lhr-solar/PS-BPSLeader/hardware/PS-BPSLeader.kicad_pcb

## KiCad design hardware/PS-BPSLeader.kicad_pcb (2026-09-20)

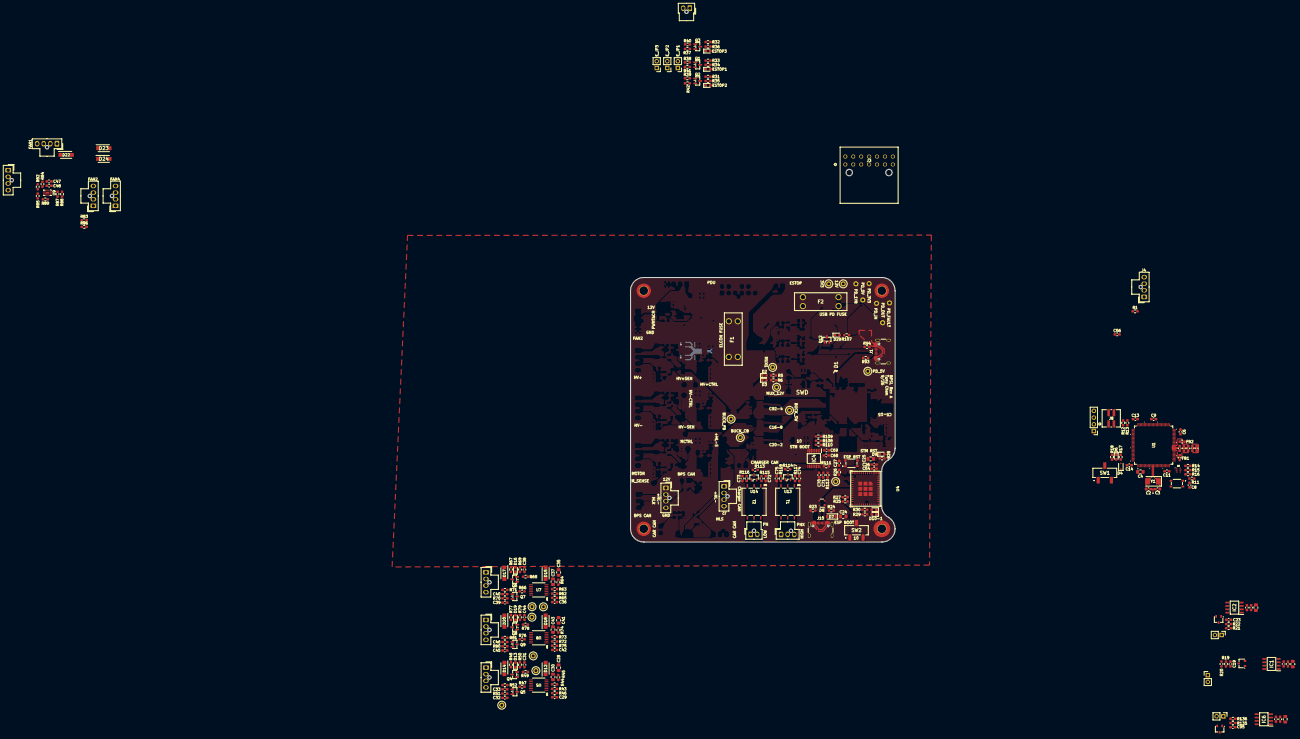
[picture p1: board PS-BPSLeader.kicad_pcb from above]

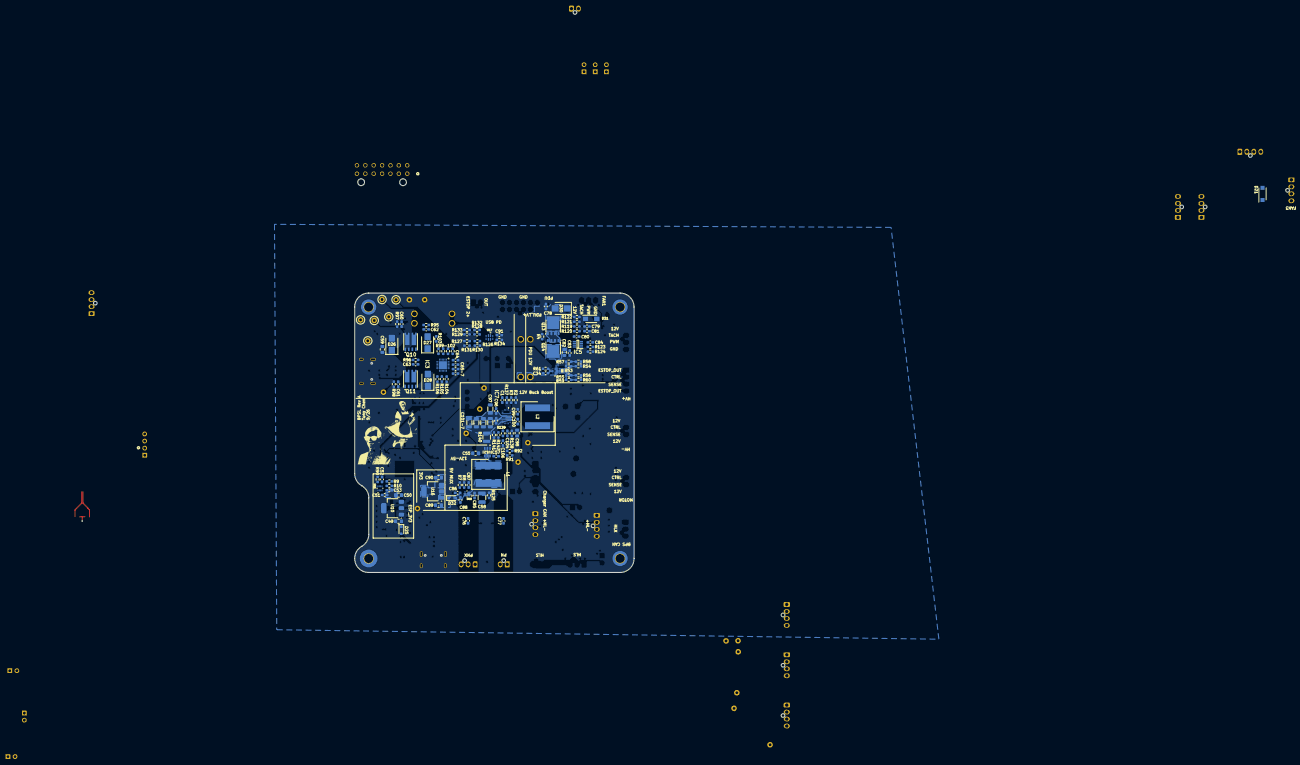
[picture p2: board PS-BPSLeader.kicad_pcb from below]

Board: 4 copper layers, 100.0 x 100.0 mm, 387 parts (131 on the bottom side), 233 nets.

Parts:
C1: 7.5n; C_0603_1608Metric_Pad1.08x0.95mm_HandSolder
C2, C3: 26p; C_0603_1608Metric_Pad1.08x0.95mm_HandSolder
C4, C16, C20, C49, C50, C82, C89, C90, C92: 10u; C_0805_2012Metric_Pad1.18x1.45mm_HandSolder
C5, C6, C7, C8, C9, C11, C13, C14, C15, C17, C18, C19, C21, C22, C23, C33, C40, C46, C68, C71, C78, C83, C84, C93, C94, C95, C96, C99, C100, C107: 0.1u; C_0603_1608Metric_Pad1.08x0.95mm_HandSolder
C10, C12, C29, C32, C34, C36, C39, C42, C45, C47, C48, C79, C91: 1u; C_0603_1608Metric_Pad1.08x0.95mm_HandSolder
C24, C25, C59: 10uF; C_0805_2012Metric_Pad1.18x1.45mm_HandSolder
C26, C27, C51, C52, C53, C54, C66, C67, C85, C86, C87, C88: 0.1uF; C_0603_1608Metric_Pad1.08x0.95mm_HandSolder
C28, C30, C35, C37, C41, C43, C55, C98: 4.7u; C_0805_2012Metric_Pad1.18x1.45mm_HandSolder
C31, C38, C44: 0.1n; C_0603_1608Metric_Pad1.08x0.95mm_HandSolder
C56, C57: 100n; C_0603_1608Metric_Pad1.08x0.95mm_HandSolder
C58: 47u; C_1210_3225Metric_Pad1.33x2.70mm_HandSolder
C60, C61, C62, C63, C64, C65: 1uF; C_0603_1608Metric_Pad1.08x0.95mm_HandSolder
C69, C70: 0.22u; C_0603_1608Metric_Pad1.08x0.95mm_HandSolder
C72, C73, C74, C75, C76, C77: 100pF; C_0603_1608Metric_Pad1.08x0.95mm_HandSolder
C80: 220n; C_0603_1608Metric_Pad1.08x0.95mm_HandSolder
C81: 10n; C_0603_1608Metric_Pad1.08x0.95mm_HandSolder
C97, C101, C102, C103, C105: 22u; C_1206_3216Metric
C104: 45p; C_0603_1608Metric_Pad1.08x0.95mm_HandSolder
C106: 90n; C_0603_1608Metric_Pad1.08x0.95mm_HandSolder
D1: TPD2EUSB30DRTR
D2, D3: LED; LED_0603_1608Metric
D4: TVS; D_SOD-323
D5: RGB_LED
D6: LED; LED_0603_1608Metric_Pad1.05x0.95mm_HandSolder
D7: 1N5819HW-7-F; D_SOD-123
D8: SP0503BAHT; SOT-143
D9: ESP_PWR; LED_0603_1608Metric_Pad1.05x0.95mm_HandSolder
D10: ESP_LED1; LED_0603_1608Metric_Pad1.05x0.95mm_HandSolder
D11: ESP_LED2; LED_0603_1608Metric_Pad1.05x0.95mm_HandSolder
D12, D14, D15, D17, D18, D20, D21, D22, D23, D24: VSSAF522-M3/H; SODFL5226X100N
D13, D16, D19: Contact; LED_0603_1608Metric_Pad1.05x0.95mm_HandSolder
D25, D32: SBA130CH-AU_R1_000A1; D_SOD-323_HandSoldering
D26: SMBJ24A-E3_52; D_SMB
D27, D28: SMBJ10A-E3_52; D_SMB
D29: FAULT; LED_0603_1608Metric_Pad1.05x0.95mm_HandSolder
D30: SMBJ15CA; D_SMB
D31: SMAF4758A; SODFL5026X125N
ESTOP1, ESTOP2, ESTOP3: LED; LED_0603_1608Metric_Pad1.05x0.95mm_HandSolder
E_JP1, E_JP2, E_JP3: Jumper_2_Open; PinHeader_1x02_P2.54mm_Vertical
F1, F2: 5A; Fuse-3557-2
FAN1, FAN2, FAN3, FAN4: Conn_01x04; Molex_Nano-Fit_105309-xx04_1x04_P2.50mm_Vertical
FB1, FB2: FerriteBead; L_0603_1608Metric_Pad1.05x0.95mm_HandSolder
H1: MountingHole_Pad; MountingHole_3.2mm_M3_Pad_TopBottom
H2, H3, H4: MountingHole_Pad; MountingHole_3.2mm_M3_ISO14580_Pad_TopBottom
IC1, IC2, IC6: TCAN3413DR
IC3: CYPD3177-24LQXQ
IC4: BQ79600PWRQ1; SOP65P640X120-16N
IC5: LM74502DDFR
IC7: TPS552872RYQR; TPS552892QWRYQRQ1
J1, J10: USB_C_Receptacle_USB2.0_16P; USB_C_Receptacle_GCT_USB4105-xx-A_16P_TopMnt_Horizontal
J2: ELCON CAN DEBUG; Molex_Nano-Fit_105309-xx04_1x04_P2.50mm_Vertical
J3: Conn_02x07_Counter_Clockwise; Molex_Microfit3.0_02x07_14-Pin-Horizontal-PCB-Receptacle_44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
J4: CAR CAN DEBUG; Molex_Nano-Fit_105309-xx04_1x04_P2.50mm_Vertical
J5: BPS CAN DEBUG; Molex_Nano-Fit_105309-xx04_1x04_P2.50mm_Vertical
J6: High Side Conn; Molex_Nano-Fit_105309-xx03_1x03_P2.50mm_Vertical
J7: Low SIde Conn; Molex_Nano-Fit_105309-xx02_1x02_P2.50mm_Vertical
J8: SWD_Header; SWD_Conn
J9: SWD; PinHeader_1x04_P2.54mm_Vertical
J11: Conn_01x02; Molex_Nano-Fit_105309-xx02_1x02_P2.50mm_Vertical
J12, J13, J14: Contactor Connector; Molex_Nano-Fit_105309-xx04_1x04_P2.50mm_Vertical
JP1, JP2, JP3: TRM; PinHeader_1x02_P2.54mm_Vertical
L1: 8.2u; 74439369082
L2: 4.7u; 74439369082
LOGO1: Dr. Hallock; LHRs_LOGO
LOGO2: Dr. Hallock; Hallock_Image_Tiny
Q1, Q2, Q3: SQ2315CES-T1_GE3; SOT-23
Q4, Q5, Q6, Q7, Q8, Q9, Q12: IRLML0030; SOT-23
Q10, Q11: SI7997DP-T1-GE3
Q13, Q14: PSMN012-100YS; LFPAK56
R1, R4, R44, R63, R73: 0; R_0603_1608Metric_Pad0.98x0.95mm_HandSolder
R2: 30.1k; R_0603_1608Metric_Pad0.98x0.95mm_HandSolder
R3, R54, R56, R58, R60, R127, R129, R131, R133: 5k; R_0603_1608Metric_Pad0.98x0.95mm_HandSolder
R5, R6, R14, R15, R16, R18, R28, R29, R30, R34, R35, R36, R45, R50, R64, R69, R74, R79, R95, R96, R101, R113, R114: 1k; R_0603_1608Metric_Pad0.98x0.95mm_HandSolder
R7: 16k; R_0603_1608Metric_Pad0.98x0.95mm_HandSolder
R8, R104: 4.7k; R_0603_1608Metric_Pad0.98x0.95mm_HandSolder
R9: 18k; R_0603_1608Metric_Pad0.98x0.95mm_HandSolder
R10, R11, R17, R25, R26, R27, R31, R32, R33, R37, R38, R39, R47, R51, R52, R66, R70, R71, R76, R80, R81, R82, R83, R85, R86, R87, R88, R90, R97, R107, R108, R109, R119, R125: 10k; R_0603_1608Metric_Pad0.98x0.95mm_HandSolder
R12, R13: 22; R_0603_1608Metric_Pad0.98x0.95mm_HandSolder
R19, R20, R21, R22, R135, R136: 60; R_0603_1608Metric_Pad0.98x0.95mm_HandSolder
R23, R24, R93, R94, R99, R100, R102: 5.1k; R_0603_1608Metric_Pad0.98x0.95mm_HandSolder
R40, R41, R42, R84, R89: 33k; R_0603_1608Metric_Pad0.98x0.95mm_HandSolder
R43, R62, R72: 66.67k; R_0603_1608Metric_Pad0.98x0.95mm_HandSolder
R46, R65, R75: 120k; R_0603_1608Metric_Pad0.98x0.95mm_HandSolder
R48, R67, R77: 4.3k; R_0603_1608Metric_Pad0.98x0.95mm_HandSolder
R49, R68, R78: 1; R_0603_1608Metric_Pad0.98x0.95mm_HandSolder
R53, R126, R132: 57.6k; R_0603_1608Metric_Pad0.98x0.95mm_HandSolder
R55: 67.3k; R_0603_1608Metric_Pad0.98x0.95mm_HandSolder
R57, R130: 26.1k; R_0603_1608Metric_Pad0.98x0.95mm_HandSolder
R59: 37.4k; R_0603_1608Metric_Pad0.98x0.95mm_HandSolder
R61, R134: 22.1k; R_0603_1608Metric_Pad0.98x0.95mm_HandSolder
R91, R110, R111, R121, R123, R128, R141: 100k; R_0603_1608Metric_Pad0.98x0.95mm_HandSolder
R92: 19.1k; R_0603_1608Metric_Pad0.98x0.95mm_HandSolder
R98, R103: 49.9k; R_0603_1608Metric_Pad0.98x0.95mm_HandSolder
R105, R106: 2.2k; R_0603_1608Metric_Pad0.98x0.95mm_HandSolder
R112: 10; R_0603_1608Metric_Pad0.98x0.95mm_HandSolder
R115, R116, R117, R118: 51; R_0603_1608Metric_Pad0.98x0.95mm_HandSolder
R120: 33; R_0603_1608Metric_Pad0.98x0.95mm_HandSolder
R122: 7.32k; R_0603_1608Metric_Pad0.98x0.95mm_HandSolder
R124: 15.8k; R_0603_1608Metric_Pad0.98x0.95mm_HandSolder
R137: 50k; R_0603_1608Metric_Pad0.98x0.95mm_HandSolder
R138: R_US; R_0603_1608Metric_Pad0.98x0.95mm_HandSolder
R139: 1.455k; R_0603_1608Metric_Pad0.98x0.95mm_HandSolder
R140: 12.5m; R_1210_3225Metric
R142: 11.1k; R_0603_1608Metric_Pad0.98x0.95mm_HandSolder
Reset1: Reset; TL3365AF180QG
SW1: SW_SPDT; BootSW
SW2: BOOT Switch; BootSW
SW3: RESET Button; TL3365AF180QG
T1, T2: HMU1228NL; HMU1228NL_PUL
TP1: PD_5V; TestPoint_Loop_D1.80mm_Drill1.0mm_Beaded
TP2: PDU_ELCON; TestPoint_Loop_D1.80mm_Drill1.0mm_Beaded
TP3: MUX_12V; TestPoint_Loop_D1.80mm_Drill1.0mm_Beaded
TP4, TP6, TP8: ctrl; TestPoint_Loop_D1.80mm_Drill1.0mm_Beaded
TP5, TP7, TP9: Sense; TestPoint_Loop_D1.80mm_Drill1.0mm_Beaded
TP10: V_in_12V; TestPoint_Loop_D1.80mm_Drill1.0mm_Beaded
TP11: CB; TestPoint_Loop_D1.80mm_Drill1.0mm_Beaded
TP12: FB; TestPoint_Loop_D1.80mm_Drill1.0mm_Beaded
TP13: SW; TestPoint_Loop_D1.80mm_Drill1.0mm_Beaded
TP14: VBUS_IN; TestPoint_Loop_D1.80mm_Drill1.0mm_Beaded
TP15: PD_VBUS_OUT; TestPoint_Loop_D1.80mm_Drill1.0mm_Beaded
TP16: PD_5V_OUT; TestPoint_Loop_D1.80mm_Drill1.0mm_Beaded
TP17: PD_1V8; TestPoint_Loop_D1.80mm_Drill1.0mm_Beaded
TP18: PD_3V3; TestPoint_Loop_D1.80mm_Drill1.0mm_Beaded
TP19: PD_FAULT; TestPoint_Loop_D1.80mm_Drill1.0mm_Beaded
TP_3.3V1, TP_3.3V2: 3.3V; TestPoint_Loop_D1.80mm_Drill1.0mm_Beaded
U1: STM32G473VETx; 100PinMCU
U2, U3, U18: CDSOT23-T24CAN
U4: ESP32-C6-MINI-1
U5, U7, U8: DRV110APWR; PW14_TEX
U6, U17: TPS2121RUXR
U9: EMC2305-1-AP-TR; QFN-16-1EP_1.8x2.6mm_P0.4mm_EP0.7x1.5mm
U10, U16: MCP1826S; SOT-223-3_TabPin2
U11, U15: TPS2117DRLR
U12: LMR51635XDDCR; DDC0006A-MFG
U13, U14: PESD5V0L2BT; SOT23_NXP
Y1: Crystal; Crystal_SMD_Abracon_ABM3-2Pin_5.0x3.2mm

Connections:
+3.3V: C4.1, C6.1, C9.1, C11.1, C13.1, C14.1, C16.1, C17.1, C18.1, C20.1, C21.1, C22.1, C47.1, C48.1, C52.1, C68.1, C90.2, C92.1, C93.1, C94.1, FB2.1, IC1.3 (VCC), IC1.5 (SHDNV_IO), IC2.3 (VCC), IC2.5 (SHDNV_IO), IC4.3 (VIO), IC6.3 (VCC), IC6.5 (SHDNV_IO), J8.1, J9.1, Q1.2 (S), Q2.2 (S), Q3.2 (S), Q5.3 (D), Q7.3 (D), Q9.3 (D), R5.1, R6.1, R11.2, R47.2, R66.2, R76.2, R82.1, R83.1, R84.1, R85.1, R86.1, R87.1, R88.1, R89.1, R108.1, R109.1, R110.1, SW1.1 (A), TP_3.3V2.1 (1_1), U1.6 (VBAT), U1.24 (VDD), U1.49 (VDD), U1.64 (VDD), U1.75 (VDD), U1.100 (VDD), U9.3 (VDD), U11.6 (VIN2), U16.3 (VO)
+3.3V_ESP: C25.1, C25.2, C26.1, C26.2, C54.1, R26.1, R27.2, R28.1, SW2.1 (A), U4.3 (3V3), U11.2 (VOUT), U11.7 (VOUT__1)
+5V: C88.1, D32.2 (A), U15.2 (VOUT), U15.7 (VOUT__1)
+12V: C28.1, C41.1, C55.1, C56.1, D14.1 (K), D20.1 (K), D21.1 (K), D22.1 (K), D23.1 (K), D24.1 (K), E_JP1.1 (A), FAN1.1, FAN2.1, FAN3.1, FAN4.1, IC7.13 (ISN), J3.6, J4.1 (12V), J5.1 (12V), J12.1 (Con+(12V)), J12.4 (Sense+(12V)), J14.1 (Con+(12V)), J14.4 (Sense+(12V)), R45.2, R48.2, R74.2, R77.2, R112.2, R140.2, R141.2, TP10.1 (1_1), U12.2 (EN), U12.3 (VIN)
/BMS/COMHN: C75.1, IC4.12 (COMHN), R114.2, R118.1
/BMS/COMHP: C74.1, IC4.13 (COMHP), R114.1, R117.1
/BMS/COMLN: C72.1, IC4.11 (COMLN), R113.1, R115.1
/BMS/COMLP: C73.1, IC4.10 (COMLP), R113.2, R116.1
/BMS/INH: IC4.16 (INH), R111.1
/BMS_NFAULT: IC4.2 (NFAULT), R110.2, U1.25 (PA3)
/BMS_UART_RX: IC4.4 (MOSI/RX), R108.2, U1.80 (PC11)
/BMS_UART_TX: IC4.5 (MISO/TX), R109.2, U1.79 (PC10)
/BPS_CAN_H: IC6.7 (CANH), J5.2 (CAN_H), R135.1, U18.1 (CAN_H)
/BPS_CAN_L: IC6.6 (CANL), J5.3 (CAN_L), JP3.2 (B), U18.2 (CAN_L)
/CAR_CAN_H: IC1.7 (CANH), J3.2, J4.2 (CAN_H), R19.1, U2.1 (CAN_H)
/CAR_CAN_L: IC1.6 (CANL), J3.3, J4.3 (CAN_L), JP1.2 (B), U2.2 (CAN_L)
/CAR_SHIELD: J3.4, R1.2
/CHARGER_CAN_H: IC2.7 (CANH), J2.2 (CAN_H), J3.13, R21.1, U3.1 (CAN_H)
/CHARGER_CAN_L: IC2.6 (CANL), J2.3 (CAN_L), J3.12, JP2.2 (B), U3.2 (CAN_L)
/ELCON_LV+: F1.1, J2.1 (12V), J3.5
/ESTOP_1-/2+: E_JP1.2 (B), E_JP2.1 (A), J3.7, J3.9, R40.2
/ESTOP_1_SENSE: R32.2, U1.84 (PD2)
/ESTOP_2-: E_JP2.2 (B), E_JP3.1 (A), J3.8, J11.1, R41.2
/ESTOP_2_SENSE: R33.2, U1.85 (PD3)
/ESTOP_3_SENSE: R31.2, U1.86 (PD4)
/ESTOP_OUT: C35.1, D17.1 (K), E_JP3.2 (B), J11.2, J13.1 (Con+(12V)), J13.4 (Sense+(12V)), R42.2, R64.2, R67.2
/FAN_ALERT: U1.94 (PB7), U9.12 (*ALERT)
/FAN_SCL: R88.2, U1.65 (PC6), U9.2 (SMCLK)
/FAN_SDA: R87.2, U1.66 (PC7), U9.1 (SMDATA)
/Fan/ADDRESS_PULLUP: R84.2, U9.4 (ADDR_SEL)
/Fan/CLK_PULLUP: R89.2, U9.11 (CLK)
/Fan/FAN_1_PWM: FAN1.3, U9.5 (PWM1)
/Fan/FAN_1_TACH: FAN1.2, R82.2, U9.6 (TACH1)
/Fan/FAN_2_PWM: FAN3.3, U9.7 (PWM2)
/Fan/FAN_2_TACH: FAN3.2, R85.2, U9.8 (TACH2)
/Fan/FAN_3_PWM: FAN2.3, U9.9 (PWM3)
/Fan/FAN_3_TACH: FAN2.2, R83.2, U9.10 (TACH3)
/Fan/FAN_4_PWM: FAN4.3, U9.13 (PWM4)
/Fan/FAN_4_TACH: FAN4.2, R86.2, U9.14 (TACH4)
/HV+ Contactor/Econ_Sense: C38.1, R69.1, U7.9 (SENSE)
/HV+ Contactor/HV_CONTROL: D16.1 (K), D17.2 (A), J13.2 (Con-), Q6.3 (D)
/HV+_CTRL: U1.98 (PE1), U7.13 (EN)
/HV+_ECON: R66.1, U1.97 (PE0), U7.12 (STATUS)
/HV+_SENSE: C39.2, Q7.2 (S), R70.2, TP7.1 (1_1), U1.96 (PB9)
/HV- Contactor/Econ_Sense: C44.1, R79.1, U8.9 (SENSE)
/HV- Contactor/HV_CONTROL: D19.1 (K), D20.2 (A), J14.2 (Con-), Q8.3 (D)
/HV-_CTRL: U1.3 (PE4), U8.13 (EN)
/HV-_ECON: R76.1, U1.2 (PE3), U8.12 (STATUS)
/HV-_SENSE: C45.2, Q9.2 (S), R80.2, TP9.1 (1_1), U1.1 (PE2)
/MOTOR_CTRL: U1.17 (PC2), U5.13 (EN)
/MOTOR_ECON: R47.1, U1.16 (PC1), U5.12 (STATUS)
/MOTOR_SENSE: C32.2, Q5.2 (S), R51.2, TP5.1 (1_1), U1.15 (PC0)
/Motor_Contactor/Econ_Sense: C31.1, R50.1, U5.9 (SENSE)
/Motor_Contactor/HV_CONTROL: D13.1 (K), D14.2 (A), J12.2 (Con-), Q4.3 (D)
/PDU_LV+: C78.1, D30.2 (A2), Q13.5, R4.1, R119.2, R121.1, R123.1
/Peripherals/100PinMCU/GNDA: C5.2, C7.2, C10.2, C12.2, C15.2, FB1.1, U1.35 (VSSA)
/Peripherals/100PinMCU/PA0: D5.5, U1.20 (PA0-GPIO_BLUE)
/Peripherals/100PinMCU/PA1: D5.3, U1.21 (PA1-GPIO_RED)
/Peripherals/100PinMCU/PA2: D5.1, U1.22 (PA2-GPIO_GREEN)
/Peripherals/100PinMCU/SWCLK: R12.1, U1.77 (PA14)
/Peripherals/100PinMCU/SWDIO: R13.1, U1.76 (PA13)
/Peripherals/100PinMCU/VDDA: C5.1, C7.1, C10.1, C12.1, C15.1, FB2.2, U1.36 (VREF+), U1.37 (VDDA)
/Peripherals/BPS_CAN_RX: IC6.4 (RXD), U1.82 (PD0)
/Peripherals/BPS_CAN_TX: IC6.1 (TXD), U1.83 (PD1)
/Peripherals/CAR_CAN_RX: IC1.4 (RXD), U1.90 (PB3)
/Peripherals/CAR_CAN_TX: IC1.1 (TXD), U1.91 (PB4)
/Peripherals/CHARGER_CAN_RX: IC2.4 (RXD), U1.92 (PB5)
/Peripherals/CHARGER_CAN_TX: IC2.1 (TXD), U1.93 (PB6)
/Peripherals/ESP32/+5V_LDO_IN: C24.1, D7.1 (K), D25.2 (A)
/Peripherals/ESP32/BOOT: R25.1, U4.23 (GPIO9)
/Peripherals/ESP32/LED1: R29.1, U4.26 (GPIO20)
/Peripherals/ESP32/LED2: R30.1, U4.27 (GPIO21)
/Peripherals/ESP32/USB_D+: D8.2 (K), J10.A6 (D+), J10.B6 (D+), U4.18 (GPIO13/USB_D+)
/Peripherals/ESP32/USB_D-: D8.3 (K), J10.A7 (D-), J10.B7 (D-), U4.17 (GPIO12/USB_D-)
/Peripherals/ESP32/VBUSB: D7.2 (A), D8.4 (K), J10.A4 (VBUS), J10.A9 (VBUS), J10.B4 (VBUS), J10.B9 (VBUS)
/Peripherals/ESP32_LDO/Vout: C50.2, C51.1, R9.1, R90.1, TP_3.3V1.1 (1_1), U10.3 (VO), U11.3 (VIN1), U11.5 (MODE)
/Peripherals/ESP32_Power_Mux/PR1: C53.1, R9.2, R10.1, U11.4 (PR1)
/Peripherals/ESP_GPIO3: U1.56 (PD9), U4.15 (MTCK/GPIO6/ADC1_CH6)
/Peripherals/ESP_GPIO4: U1.57 (PD10), U4.16 (MTDO/GPIO7)
/Peripherals/ESP_NRST: C27.1, R26.2, SW3.1, U1.58 (PD11), U4.8 (EN/CHIP_PU)
/Peripherals/STM_BOOT: R17.1, U1.95 (PB8-BOOT0), U4.12 (GPIO0/ADC1_CH0/XTAL_32K_P)
/Peripherals/STM_NRST: C8.1, R11.1, Reset1.1, U1.14 (PG10-NRST), U4.13 (GPIO1/ADC1_CH1/XTAL_32K_N)
/Peripherals/STM_RX: U1.71 (PA10), U4.31 (U0TXD/GPIO16)
/Peripherals/STM_TX: U1.70 (PA9), U4.30 (U0RXD/GPIO17)
/Power/5V_BUCK: C58.1, C85.1, L1.2, R91.1, R125.1, U15.3 (VIN1), U15.5 (MODE)
/Power/12VBuck/CB: C57.1, TP11.1 (1_1), U12.6 (CB)
/Power/12VBuck/FB: R91.2, R92.1, TP12.1 (1_1), U12.1 (FB)
/Power/12VBuck/SW: C57.2, L1.1, TP13.1 (1_1), U12.5 (SW)
/Power/12V_CC: D3.1 (K), IC7.4 (~CC)
/Power/12V_DITH: C1.1, IC7.5 (DITH/SYNC)
/Power/12V_PG: D2.1 (K), IC7.3 (PG)
/Power/EN: IC7.1 (EN/UVLO), IC7.2 (MODE), R2.2, R3.1
/Power/MUX_12V: C96.1, C97.1, IC7.7 (VIN), R2.1, TP3.1 (1_1), U17.1 (OUT), U17.8 (OUT)
/Power/PDU_12V: C82.1, Q14.5, R4.2, R53.1, R57.1, U6.7 (IN1)
/Power/PD_5V_OUT: C63.1, C86.1, Q11.5 (D2), Q11.6 (D2), Q11.10 (D2), Q11.12 (D2), R7.1, TP1.1 (1_1), TP16.1 (1_1), U15.6 (VIN2)
/Power/PowerProtection/EN/UVLO: C84.2, IC5.1 (EN/UVLO), R123.2, R124.2
/Power/PowerProtection/OV: C83.2, IC5.7 (OV), R121.2, R122.1
/Power/PowerProtection/gate: IC5.6 (GATE), Q13.4, Q14.4, R120.2
/Power/PowerProtection/source: IC5.8 (SRC), Q13.1, Q13.2, Q13.3, Q14.1, Q14.2, Q14.3
/Power/Power_5VMux/PR1: C87.1, R7.2, R8.1, U15.4 (PR1)
/Power/Power_Mux_PD/CP2: R132.2, R133.1, U17.3 (CP2)
/Power/Power_Mux_PD/OV1: R126.2, R127.1, U17.5 (OV1)
/Power/Power_Mux_PD/OV2: R128.2, R129.1, U17.4 (OV2)
/Power/Power_Mux_PD/PRI: R130.2, R131.1, U17.6 (PR1)
/Power/Power_Mux_PD/Vin1: R126.1, R130.1, TP2.1 (1_1), U6.1 (OUT), U6.8 (OUT), U17.7 (IN1)
/Power/Power_Mux_PD/Vin2: F2.2, R128.1, R132.1, U17.2 (IN2)
/Power/Power_Mux_PDU_ELCON/CP2: R59.2, R60.1, U6.3 (CP2)
/Power/Power_Mux_PDU_ELCON/OV1: R53.2, R54.1, U6.5 (OV1)
/Power/Power_Mux_PDU_ELCON/OV2: R55.2, R56.1, U6.4 (OV2)
/Power/Power_Mux_PDU_ELCON/PRI: R57.2, R58.1, U6.6 (PR1)
/Power/Power_Mux_PDU_ELCON/Vin2: F1.2, R55.1, R59.1, U6.2 (IN2)
/Power/Power_USB_PD/ISINK_COARSE: IC3.5 (ISNK_COARSE), R100.2, R102.1
/Power/Power_USB_PD/PD_1V8: C64.2, IC3.24 (VCCD), TP17.1 (1_1)
/Power/Power_USB_PD/PD_3V3: C65.1, C66.1, C67.1, IC3.2 (VBUS_MAX), IC3.23 (VDDD), R99.1, R100.1, R104.1, R105.1, R106.1, TP18.1 (1_1)
/Power/Power_USB_PD/PD_FAULT: IC3.9 (FAULT), Q12.1 (G), TP19.1 (1_1)
/Power/Power_USB_PD/SAFE_PWR_EN: IC3.4 (SAFE_PWR_EN), R96.2
/Power/Power_USB_PD/VBUS_FET_EN: IC3.3 (VBUS_FET_EN), R95.2
/Power/Power_USB_PD/VBUS_MIN: IC3.1 (VBUS_MIN), R99.2, R101.1
/Power/USB_PD_OUT: C62.1, F2.1, IC3.11 (VDC_OUT), Q10.5 (D2), Q10.6 (D2), Q10.10 (D2), Q10.12 (D2), TP15.1 (1_1)
/USB_CC1: IC3.15 (CC1), J1.A5 (CC1), R93.1
/USB_CC2: IC3.14 (CC2), J1.B5 (CC2), R94.1
/USB_D+: D1.1 (D+), J1.A6 (D+), J1.B6 (D+), U1.73 (PA12)
/USB_D-: D1.2 (D-), J1.A7 (D-), J1.B7 (D-), U1.72 (PA11)
/USB_GPIO: IC3.8 (GPIO_1), U1.69 (PA8)
/USB_SCL: IC3.13 (HPI_SCL), R105.2, U1.67 (PC8)
/USB_SDA: IC3.12 (HPI_SDA), R106.2, U1.68 (PC9)
/USB_VBUS_IN: C59.1, C60.1, C61.1, D26.1 (K), IC3.18 (VBUS_IN), J1.A4 (VBUS), J1.A9 (VBUS), J1.B4 (VBUS), J1.B9 (VBUS), Q10.7 (D1), Q10.8 (D1), Q10.9 (D1), Q10.11 (D1), Q11.7 (D1), Q11.8 (D1), Q11.9 (D1), Q11.11 (D1), R97.2, R98.2, R107.1, TP14.1 (1_1)
/isolatedCOMHN: J6.2, T1.4 (TX-)
/isolatedCOMHP: J6.1, T1.6 (TX+)
/isolatedCOMLN: J7.2, T2.6 (TX+)
/isolatedCOMLP: J7.1, T2.4 (TX-)
GND: C1.2, C2.1, C3.1, C4.2, C6.2, C8.2, C9.2, C11.2, C13.2, C14.2, C16.2, C17.2, C18.2, C19.2, C20.2, C21.2, C22.2, C23.2, C24.2, C27.2, C28.2, C29.2, C30.2, C31.2, C32.1, C33.1, C34.2, C35.2, C36.2, C37.2, C38.2, C39.1, C40.1, C41.2, C42.2, C43.2, C44.2, C45.1, C46.1, C47.2, C48.2, C49.1, C50.1, C51.2, C52.2, C53.2, C54.2, C55.2, C56.2, C58.2, C59.2, C64.1, C65.2, C66.2, C67.2, C68.2, C69.2, C70.2, C71.2, C72.2, C73.2, C74.2, C75.2, C76.1, C77.1, C78.2, C79.1, C81.2, C82.2, C83.1, C84.1, C85.2, C86.2, C87.2, C88.2, C89.1, C90.1, C91.2, C92.2, C93.2, C94.2, C95.2, C96.2, C97.2, C98.2, C101.2, C102.2, C103.2, C104.2, C105.2, C106.2, C107.2, D1.3 (GND), D4.1 (A1), D8.1 (A), D9.1 (K), D10.1 (K), D11.1 (K), D12.2 (A), D15.2 (A), D18.2 (A), D21.2 (A), D22.2 (A), D23.2 (A), D24.2 (A), D26.2 (A), D30.1 (A1), D31.2 (A), ESTOP1.1 (K), ESTOP2.1 (K), ESTOP3.1 (K), FAN1.4, FAN2.4, FAN3.4, FAN4.4, FB1.2, IC1.2 (GND), IC1.8 (STB), IC2.2 (GND), IC2.8 (STB), IC3.6 (ISNK_FINE), IC3.19 (GND_1), IC3.22 (GND_2), IC3.25 (GND_3), IC4.6 (SCLK), IC4.7 (NCS), IC4.8 (NUART/SPI_(SPI_RDY)), IC4.9 (GND), IC5.2 (GND), IC6.2 (GND), IC6.8 (STB), IC7.9 (PGND_1), IC7.17 (AGND), IC7.22 (PGND_2), IC7.23 (PGND_3), J1.A1 (GND), J1.A12 (GND), J1.B1 (GND), J1.B12 (GND), J1.S1 (SHIELD), J1.S2 (Shield), J1.S3 (Shield), J1.S4 (Shield), J2.4 (GND), J3.10, J3.11, J3.14, J4.4 (GND), J5.4 (GND), J8.2, J9.2, J10.A1 (GND), J10.A12 (GND), J10.B1 (GND), J10.B12 (GND), J10.S1 (SHIELD), J10.S2 (Shield), J10.S3 (Shield), J10.S4 (Shield), Q12.2 (S), R1.1, R3.2, R8.2, R10.2, R14.2, R15.2, R16.2, R18.2, R23.2, R24.2, R37.1, R38.1, R39.1, R43.1, R44.1, R46.1, R49.1, R51.1, R54.2, R56.2, R58.2, R60.2, R61.2, R62.1, R63.1, R65.1, R68.1, R70.1, R72.1, R73.1, R75.1, R78.1, R80.1, R92.2, R93.2, R94.2, R101.2, R102.2, R111.2, R122.2, R124.1, R127.2, R129.2, R131.2, R133.2, R134.2, R137.1, R138.1, R142.2, Reset1.2, SW1.3 (C), SW2.3 (C), SW3.2, U1.23 (VSS), U1.48 (VSS), U1.63 (VSS), U1.74 (VSS), U1.99 (VSS), U2.3 (GND), U3.3 (GND), U4.1 (GND), U4.2 (GND), U4.11 (GND), U4.14 (GND), U4.36 (GND), U4.37 (GND), U4.38 (GND), U4.39 (GND), U4.40 (GND), U4.41 (GND), U4.42 (GND), U4.43 (GND), U4.44 (GND), U4.45 (GND), U4.46 (GND), U4.47 (GND), U4.48 (GND), U4.49 (GND), U4.50 (GND), U4.51 (GND), U4.52 (GND), U4.53 (GND), U5.8 (GND), U6.9 (ST), U6.12 (GND), U7.8 (GND), U8.8 (GND), U9.17 (EPAD), U10.2 (GND), U11.1 (GND), U12.4 (GND), U13.3, U14.3, U15.1 (GND), U16.2 (GND), U17.9 (ST), U17.12 (GND), U18.3 (GND)
unnamed: C19.1, R19.2, R20.1
unnamed: C23.1, R21.2, R22.1
unnamed: C81.1, R120.1
unnamed: C95.1, R135.2, R136.1
unnamed: C106.1, R139.2
unnamed: D2.2 (A), R5.2
unnamed: D3.2 (A), R6.2
unnamed: D4.2 (A2), D6.2 (A), R17.2, SW1.2 (B)
unnamed: D5.2, R14.1
unnamed: D5.4, R15.1
unnamed: D5.6, R16.1
unnamed: D6.1 (K), R18.1
unnamed: D9.2 (A), R28.2
unnamed: D10.2 (A), R29.2
unnamed: D11.2 (A), R30.2
unnamed: C30.1, D12.1 (K), R45.1, U5.7 (VIN)
unnamed: D13.2 (A), R48.1
unnamed: C37.1, D15.1 (K), R64.1, U7.7 (VIN)
unnamed: D16.2 (A), R67.1
unnamed: C43.1, D18.1 (K), R74.1, U8.7 (VIN)
unnamed: D19.2 (A), R77.1
unnamed: C49.2, D25.1 (K), U10.1 (VI)
unnamed: C60.2, C62.2, D27.2 (A), Q10.2 (G1), Q10.4 (G2), R95.1, R97.1, R103.1
unnamed: D27.1 (K), Q10.1 (S1), Q10.3 (S2), R103.2
unnamed: C61.2, C63.2, D28.2 (A), Q11.2 (G1), Q11.4 (G2), R96.1, R98.1
unnamed: D28.1 (K), Q11.1 (S1), Q11.3 (S2)
unnamed: D29.2 (A), R107.2
unnamed: D29.1 (K), Q12.3 (D)
unnamed: C79.2, C80.1, D31.1 (K), IC5.5 (VS), R119.1
unnamed: C89.2, D32.1 (K), U16.1 (VI)
unnamed: ESTOP1.2 (A), R34.2
unnamed: ESTOP2.2 (A), R35.2
unnamed: ESTOP3.2 (A), R36.2
unnamed: IC3.10 (FLIP), R104.2
unnamed: C71.1, IC4.15 (BAT), R112.1
unnamed: C70.1, IC4.14 (CVDD)
unnamed: C69.1, IC4.1 (DVDD)
unnamed: C80.2, IC5.4 (VCAP)
unnamed: C99.1, IC7.20 (BOOT1)
unnamed: C100.2, IC7.19 (BOOT2)
unnamed: IC7.16 (CDC), R138.2
unnamed: C104.1, IC7.15 (COMP), R139.1
unnamed: IC7.14 (FB), R141.1, R142.1
unnamed: IC7.6 (FSW), R137.2
unnamed: C101.1, C102.1, C103.1, C105.1, C107.1, IC7.11 (VOUT), IC7.12 (ISP), R140.1
unnamed: C99.2, IC7.8 (SW1), L2.1
unnamed: C100.1, IC7.10 (SW2), L2.2
unnamed: C98.1, IC7.18 (VCC)
unnamed: J8.3, J9.3, R12.2
unnamed: J8.4, J9.4, R13.2
unnamed: J10.A5 (CC1), R23.1
unnamed: J10.B5 (CC2), R24.1
unnamed: J12.3 (Sense-), R52.1
unnamed: J13.3 (Sense-), R71.1
unnamed: J14.3 (Sense-), R81.1
unnamed: JP1.1 (A), R20.2
unnamed: JP2.1 (A), R22.2
unnamed: JP3.1 (A), R136.2
unnamed: Q1.3 (D), R33.1, R34.1
unnamed: Q1.1 (G), R38.2, R41.1
unnamed: Q2.3 (D), R31.1, R35.1
unnamed: Q2.1 (G), R39.2, R42.1
unnamed: Q3.3 (D), R32.1, R36.1
unnamed: Q3.1 (G), R37.2, R40.1
unnamed: Q4.1 (G), TP4.1 (1_1), U5.11 (OUT)
unnamed: Q4.2 (S), R49.2, R50.2
unnamed: C33.2, Q5.1 (G), R52.2
unnamed: Q6.1 (G), TP6.1 (1_1), U7.11 (OUT)
unnamed: Q6.2 (S), R68.2, R69.2
unnamed: C40.2, Q7.1 (G), R71.2
unnamed: Q8.1 (G), TP8.1 (1_1), U8.11 (OUT)
unnamed: Q8.2 (S), R78.2, R79.2
unnamed: C46.2, Q9.1 (G), R81.2
unnamed: R25.2, SW2.2 (B)
unnamed: C76.2, T1.2 (TCT)
unnamed: R117.2, T1.1 (TD+), U13.2
unnamed: R118.2, T1.3 (TD-), U13.1
unnamed: C77.2, T2.2 (TCT)
unnamed: R115.2, T2.1 (TD+), U14.2
unnamed: R116.2, T2.3 (TD-), U14.1
unnamed: C2.2, U1.12 (PF0-OSC_IN), Y1.2
unnamed: C3.2, U1.13 (PF1-OSC_OUT), Y1.1
unnamed: R27.1, U4.22 (GPIO8)
unnamed: R43.2, U5.4 (HOLD)
unnamed: C29.1, U5.2 (KEEP)
unnamed: R44.2, U5.5 (OSC)
unnamed: R46.2, U5.3 (PEAK)
unnamed: R61.1, U6.10 (ILIM)
unnamed: C34.1, U6.11 (SS)
unnamed: R62.2, U7.4 (HOLD)
unnamed: C36.1, U7.2 (KEEP)
unnamed: R63.2, U7.5 (OSC)
unnamed: R65.2, U7.3 (PEAK)
unnamed: R72.2, U8.4 (HOLD)
unnamed: C42.1, U8.2 (KEEP)
unnamed: R73.2, U8.5 (OSC)
unnamed: R75.2, U8.3 (PEAK)
unnamed: R90.2, U11.8 (ST)
unnamed: R125.2, U15.8 (ST)
unnamed: R134.1, U17.10 (ILIM)
unnamed: C91.1, U17.11 (SS)
