lhr-solar/PS-BPSLeader/Software/Drivers/Inc/ADC_Array_LUT.h

#pragma once

#include <stdint.h>

// 12-bit ADC Lookup Table
// Output Units: millivolts (mV)
// Range: 0 mV to 311689 mV

static const uint32_t Array_LUT[4096] = {
    0, 76, 152, 228, 304, 381, 457, 533,
    609, 685, 761, 837, 913, 989, 1066, 1142,
    1218, 1294, 1370, 1446, 1522, 1598, 1675, 1751,
    1827, 1903, 1979, 2055, 2131, 2207, 2283, 2360,
    2436, 2512, 2588, 2664, 2740, 2816, 2892, 2968,
    3045, 3121, 3197, 3273, 3349, 3425, 3501, 3577,
    3653, 3730, 3806, 3882, 3958, 4034, 4110, 4186,
    4262, 4339, 4415, 4491, 4567, 4643, 4719, 4795,
    4871, 4947, 5024, 5100, 5176, 5252, 5328, 5404,
    5480, 5556, 5632, 5709, 5785, 5861, 5937, 6013,
    6089, 6165, 6241, 6318, 6394, 6470, 6546, 6622,
    6698, 6774, 6850, 6926, 7003, 7079, 7155, 7231,
    7307, 7383, 7459, 7535, 7611, 7688, 7764, 7840,
    7916, 7992, 8068, 8144, 8220, 8296, 8373, 8449,
    8525, 8601, 8677, 8753, 8829, 8905, 8982, 9058,
    9134, 9210, 9286, 9362, 9438, 9514, 9590, 9667,
    9743, 9819, 9895, 9971, 10047, 10123, 10199, 10275,
    10352, 10428, 10504, 10580, 10656, 10732, 10808, 10884,
    10960, 11037, 11113, 11189, 11265, 11341, 11417, 11493,
    11569, 11646, 11722, 11798, 11874, 11950, 12026, 12102,
    12178, 12254, 12331, 12407, 12483, 12559, 12635, 12711,
    12787, 12863, 12939, 13016, 13092, 13168, 13244, 13320,
    13396, 13472, 13548, 13624, 13701, 13777, 13853, 13929,
    14005, 14081, 14157, 14233, 14310, 14386, 14462, 14538,
    14614, 14690, 14766, 14842, 14918, 14995, 15071, 15147,
    15223, 15299, 15375, 15451, 15527, 15603, 15680, 15756,
    15832, 15908, 15984, 16060, 16136, 16212, 16289, 16365,
    16441, 16517, 16593, 16669, 16745, 16821, 16897, 16974,
    17050, 17126, 17202, 17278, 17354, 17430, 17506, 17582,
    17659, 17735, 17811, 17887, 17963, 18039, 18115, 18191,
    18267, 18344, 18420, 18496, 18572, 18648, 18724, 18800,
    18876, 18953, 19029, 19105, 19181, 19257, 19333, 19409,
    19485, 19561, 19638, 19714, 19790, 19866, 19942, 20018,
    20094, 20170, 20246, 20323, 20399, 20475, 20551, 20627,
    20703, 20779, 20855, 20931, 21008, 21084, 21160, 21236,
    21312, 21388, 21464, 21540, 21617, 21693, 21769, 21845,
    21921, 21997, 22073, 22149, 22225, 22302, 22378, 22454,
    22530, 22606, 22682, 22758, 22834, 22910, 22987, 23063,
    23139, 23215, 23291, 23367, 23443, 23519, 23596, 23672,
    23748, 23824, 23900, 23976, 24052, 24128, 24204, 24281,
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
};
