lhr-solar/PS-BPSLeader/Software/Tasks/Src/PrechageTask.c

#include "PrechargeTask.h"
#include "FaultHandlerTask.h"
#include "config.h"

// Defined macro is now actually used below
#define PRECHARGE_PRINTF_DEBUG_PERIOD_MS 1000
#define PRECHARGE_PRINTF_DEBUG_COUNTER (PRECHARGE_PRINTF_DEBUG_PERIOD_MS / PRECHARGE_TASK_DELAY_MS)

// Dash sends this message every 100 mS, so wait for double that
#define IGNITION_STATUS_TIMEOUT_MS 200

TaskHandle_t hprecharge_task = NULL;

StaticEventGroup_t xPrechargeEventGroup;
EventGroupHandle_t xPrechargeEventGroup_handle;

// The handle for our software timer
static TimerHandle_t xPrechargeTimer = NULL;
static StaticTimer_t xPrechargeTimer_buffer;

static uint8_t under_voltage_error_count = 0;

// Flag to communicate between the Timer Task and Precharge Task
static volatile bool precharge_timeout_expired = false;

// The callback function executed by the FreeRTOS Timer Daemon
void PrechargeTimeoutCallback(TimerHandle_t xTimer)
{
    precharge_timeout_expired = true;
}

void Init_PrechargeTask(void)
{
    xPrechargeEventGroup_handle = xEventGroupCreateStatic(&xPrechargeEventGroup);
    configASSERT(xPrechargeEventGroup_handle);

    if (ADC_Sense_Init() != ADC_SENSE_OK)
    {
        set_faultBit(ADC_ERROR);
    }
    // Create a One-Shot timer (pdFALSE) that does not auto-reload
    xPrechargeTimer = xTimerCreateStatic(
        "PrechargeTmr",                      // Text name
        pdMS_TO_TICKS(PRECHARGE_TIMEOUT_MS), // Timer period
        pdFALSE,                             // pdFALSE = One-Shot, pdTRUE = Auto-Reload
        (void *) 0,                          // Timer ID (not used here)
        PrechargeTimeoutCallback,             // Callback function
        &xPrechargeTimer_buffer              // buffer for precharge timer
    );
}

// could make another eventgroup to distinguish
void Fault_Checker(uint32_t Array_Voltage, uint32_t Battery_Voltage, Precharge_State_t State)
{
    // Use uint64_t to prevent overflow during scaled multiplication of large mV values
    if ((Array_Voltage * VOLTAGE_TOLERANCE_DENOMINATOR) > (Battery_Voltage * VOLTAGE_TOLERANCE_NUMERATOR))
    {
        //set_faultBit(ARRAY_GREATER_THAN_BATTERY_FAULT);
    }

    if (Battery_Voltage > PACK_OVERVOLTAGE_THRESHOLD_MV)
    {
        /* BATTERY ABOUT TO GO BOOM */
        set_faultBit(PACK_OVERVOLTAGE_FAULT);
    }

    if ((Battery_Voltage < PACK_UNDERVOLTAGE_THRESHOLD_MV) && (State != PRECHARGE_STATE_IDLE) && (State != PRECHARGE_STATE_FAULT))
    {
        if (State == PRECHARGE_STATE_PRECHARGING) {
            under_voltage_error_count++;
        }
        else {
            /* Battery voltage is too low or battery is disconnected, treat as fault */
            set_faultBit(PACK_UNDERVOLTAGE_FAULT);
        }

        if (under_voltage_error_count > PRECHARGE_UNDERVOLTAGE_DEBOUNCE_LIMIT) {
            set_faultBit(PACK_UNDERVOLTAGE_FAULT);
        }
    }
    else under_voltage_error_count = 0;
}

static void print_Precharge_State(Precharge_State_t State)
{
    switch (State)
    {
    case PRECHARGE_STATE_IDLE:
        printf("Precharge State: IDLE\r\n");
        break;
    case PRECHARGE_STATE_INITIAL:
        printf("Precharge State: Initial\r\n");
        break;
    case PRECHARGE_STATE_PRECHARGING:
        printf("Precharge State: Precharging\r\n");
        break;
    case PRECHARGE_STATE_RUN:
        printf("Precharge State: Run\r\n");
        break;
    case PRECHARGE_STATE_FAULT:
        printf("Precharge State: FAULT\r\n");
        break;
    default:
        printf("Precharge State: Unknown\r\n");
        break;
    }
}

static can_status_t CarCAN_Recv_Driver_Input(driver_input_status_t *out, TickType_t delay) {
    if (out == NULL) return CAN_EMPTY;

    FDCAN_RxHeaderTypeDef header = {0};
    uint8_t driver_input_rx_data[CAN_DLC_DRIVER_INPUT_STATUS] = {0};

    can_status_t result = can_fd_recv(car_can, CAN_ID_DRIVER_INPUT_STATUS, &header, driver_input_rx_data, delay);

    if (result == CAN_OK) {
        out->Ignition_Array   = !!(driver_input_rx_data[0] & (1U << 0));
        out->Ignition_Motor   = !!(driver_input_rx_data[0] & (1U << 1));
        out->Ignition_Off     = !!(driver_input_rx_data[0] & (1U << 2));
        out->Cruise_Enable    = !!(driver_input_rx_data[0] & (1U << 3));
        out->Cruise_Set       = !!(driver_input_rx_data[0] & (1U << 4));
        out->Gear_Forward     = !!(driver_input_rx_data[0] & (1U << 5));
        out->Gear_Neutral     = !!(driver_input_rx_data[0] & (1U << 6));
        out->Gear_Reverse     = !!(driver_input_rx_data[0] & (1U << 7));

        out->Hazard_Pressed      = !!(driver_input_rx_data[1] & (1U << 0));
        out->Horn_Pressed        = !!(driver_input_rx_data[1] & (1U << 1));
        out->Blinker_Left        = !!(driver_input_rx_data[1] & (1U << 2));
        out->Blinker_Right       = !!(driver_input_rx_data[1] & (1U << 3));
        out->PushToTalk_Pressed  = !!(driver_input_rx_data[1] & (1U << 4));
        out->Regen_Activate      = !!(driver_input_rx_data[1] & (1U << 5));
        out->Regen_Enable        = !!(driver_input_rx_data[1] & (1U << 6));
    }

    return result;
}

static can_status_t CarCAN_Send_Precharge_Voltages(uint32_t battery_voltage, uint32_t array_voltage, TickType_t delay_ms){

    uint8_t msgData[CAN_DLC_BPS_PRECHARGE_VOLTAGES] = {0};
    // Pack battery voltage (bits 0-23)
    msgData[0] = battery_voltage & 0xFF; // bits 0-7
    msgData[1] = (battery_voltage >> 8) & 0xFF; // bits 8-15
    msgData[2] = (battery_voltage >> 16) & 0xFF; // bits 16-23  
    // Pack array voltage (bits 24-47)
    msgData[3] = array_voltage & 0xFF; // bits 24-31
    msgData[4] = (array_voltage >> 8) & 0xFF; // bits 32-39
    msgData[5] = (array_voltage >> 16) & 0xFF; // bits 40-47

    return car_can_send(CAN_ID_BPS_PRECHARGE_VOLTAGES, msgData, CAN_DLC_BPS_PRECHARGE_VOLTAGES, delay_ms);
}


void Task_Precharge(void *pvParameters)
{
    Init_PrechargeTask();

    static Precharge_State_t current_precharge_state = PRECHARGE_STATE_IDLE;   
    uint32_t printDebugCounter = 0;

    TickType_t xLastWakeTime = xTaskGetTickCount();

    // contains the state of the ignition switch
    driver_input_status_t driver_input_status = {0};

    /** Precharge sequence
    // TODO: add info about the precharge sequence here
     */

    while (1)
    {

        vTaskDelayUntil(&xLastWakeTime, pdMS_TO_TICKS(PRECHARGE_TASK_DELAY_MS));

        //get the latest driver input status from CAN to check the ignition switch positon
        can_status_t driver_can_status = CarCAN_Recv_Driver_Input(&driver_input_status, pdMS_TO_TICKS(IGNITION_STATUS_TIMEOUT_MS));
       
        // if we don't recieve the driver status in time then turn of all the array contactors and go back to idle
        if (driver_can_status != CAN_OK) {

            // only print it out once to prevent spamming
            if(current_precharge_state != PRECHARGE_STATE_IDLE && current_precharge_state != PRECHARGE_STATE_FAULT){
                printf("Precharge Back To Idle due to CAN timeout\r\n");
            }
            current_precharge_state = PRECHARGE_STATE_IDLE;
        }
        // driver status message recieved and ignition switch is off
        else if(driver_input_status.Ignition_Array == 0){

            if(current_precharge_state != PRECHARGE_STATE_IDLE && current_precharge_state != PRECHARGE_STATE_FAULT){
                printf("Precharge Back To Idle due to Ignition Switch Off\r\n");
            }
            current_precharge_state = PRECHARGE_STATE_IDLE;
        }
        // else the State can remain as is
        ADC_Sense_Result ADC_Result = {0};

        // to let your fault handler safely open contactors.
        if (Read_ADC(ADC_TIMEOUT_MS, &ADC_Result) != ADC_SENSE_OK)
        {
            set_faultBit(ADC_ERROR);
        }

        uint32_t Battery_Voltage = ADC_Result.Battery_Voltage;
        uint32_t Array_Voltage = ADC_Result.Array_Voltage;

        printDebugCounter++;

        // if any fault is set, or we are already in fault state, stay in fault state until reset
        if (is_fault_set(NUM_FAULTS) || current_precharge_state == PRECHARGE_STATE_FAULT){ 
            current_precharge_state = PRECHARGE_STATE_FAULT;
        }

        // used to store previous precharge state to see if the state has changed and print it out
        Precharge_State_t previousState = current_precharge_state;

        switch (current_precharge_state)
        {
            case PRECHARGE_STATE_IDLE:

                // idle runs theoretically with no contactors closed, so cannot check for voltage faults

                // disable the array and array precharge contactors if they are not already open
                if (contactor_get(ARRAY_PRE_CONTACTOR) != CONTACTOR_OPEN) {
                    contactor_set(ARRAY_PRE_CONTACTOR, CONTACTOR_OPEN, CALLBACK_BLOCKING_TIME_MS, NORMAL);
                }
                if (contactor_get(ARRAY_CONTACTOR) != CONTACTOR_OPEN) { 
                    contactor_set(ARRAY_CONTACTOR, CONTACTOR_OPEN, CALLBACK_BLOCKING_TIME_MS, NORMAL);
                }

                // if the ignition is at array, then we can enable the array contactor in the next iteration
                // only do this if it's currently in idle otherwise you will override if in a different state
                if (driver_input_status.Ignition_Array) 
                {
                    // if Contactors are on then BPS has been safety checked
                    if(contactor_get(HV_PLUS_CONTACTOR) == CONTACTOR_CLOSED && contactor_get(HV_MINUS_CONTACTOR) == CONTACTOR_CLOSED)
                    {
                        current_precharge_state = PRECHARGE_STATE_INITIAL;
                    }
                    else
                    {
                        current_precharge_state = PRECHARGE_STATE_IDLE;
                    }
                }
                else
                {
                    // if the ignition is not at array, then keep the system in idle
                    current_precharge_state = PRECHARGE_STATE_IDLE;
                }
                break;

            case PRECHARGE_STATE_INITIAL:
                if (contactor_set(ARRAY_CONTACTOR, CONTACTOR_CLOSED, CALLBACK_BLOCKING_TIME_MS, NORMAL) != CONTACTOR_OK)
                {
                    set_faultBit(CONTACTOR_ARRAY_FAULT);
                }

                current_precharge_state = PRECHARGE_STATE_PRECHARGING;
                xTimerStart(xPrechargeTimer, 0); // Start the timer
                break;

            case PRECHARGE_STATE_PRECHARGING:
                Fault_Checker(Array_Voltage, Battery_Voltage, current_precharge_state);

                // Check if array votage is close to battery voltage
                if ((Array_Voltage * mV_TO_V_SCALAR) >= (Battery_Voltage * PRECHARGE_THRESHOLD_90))
                {
                    // stop timer since we did it we precharged
                    xTimerStop(xPrechargeTimer, 0);

                    // precharge is complete
                    if (contactor_set(ARRAY_PRE_CONTACTOR, CONTACTOR_CLOSED, CALLBACK_BLOCKING_TIME_MS, NORMAL) != CONTACTOR_OK)
                    {
                        set_faultBit(CONTACTOR_ARRAY_PRE_FAULT);
                    }

                    current_precharge_state = PRECHARGE_STATE_RUN;
                }

                // Precharge is not complete, so we check to see if it's taken too long
                else if (precharge_timeout_expired)
                {
                    set_faultBit(PRECHARGE_TIMEOUT_FAULT);
                    current_precharge_state = PRECHARGE_STATE_FAULT; // Park in idle after faulting
                }
                break;

            case PRECHARGE_STATE_RUN:
                Fault_Checker(Array_Voltage, Battery_Voltage, current_precharge_state);

                // Use 80% threshold for hysteresis
                if ((Array_Voltage * mV_TO_V_SCALAR) < (Battery_Voltage * PRECHARGE_THRESHOLD_80))
                {
                    set_faultBit(PRECHARGE_OUT_OF_BOUNDS_FAULT);
                }
                break;

            case PRECHARGE_STATE_FAULT:
                
                // disable the array and array precharge contactors if they are not already open
                if (contactor_get(ARRAY_PRE_CONTACTOR) != CONTACTOR_OPEN) {
                    contactor_set(ARRAY_PRE_CONTACTOR, CONTACTOR_OPEN, CALLBACK_BLOCKING_TIME_MS, NORMAL);
                }
                if (contactor_get(ARRAY_CONTACTOR) != CONTACTOR_OPEN) { 
                    contactor_set(ARRAY_CONTACTOR, CONTACTOR_OPEN, CALLBACK_BLOCKING_TIME_MS, NORMAL);
                }

                xTimerStop(xPrechargeTimer, 0);
                Fault_Checker(Array_Voltage, Battery_Voltage, current_precharge_state);

                break;

            default:
                break;
        }

        if(current_precharge_state != previousState){
            printf("Precharge State Changed to: ");
            print_Precharge_State(current_precharge_state);
        }

        // print voltages and state every PRECHARGE_PRINTF_DEBUG_PERIOD_MS ms for debugging
        if (printDebugCounter >= PRECHARGE_PRINTF_DEBUG_COUNTER)
        {
            printf("Battery: %lu mV | Array: %lu mV\r\n", Battery_Voltage, Array_Voltage);
            print_Precharge_State(current_precharge_state);
            printDebugCounter = 0;
        }

        CarCAN_Send_Precharge_Voltages(Battery_Voltage, Array_Voltage, PRECHARGE_TASK_DELAY_MS / 2);
        
        static bool mppts_enabled = false;
        // if array precharge is complete, then enable the MPPTs
        if(contactor_get(ARRAY_CONTACTOR) == CONTACTOR_CLOSED && contactor_get(ARRAY_PRE_CONTACTOR) == CONTACTOR_CLOSED){
            if(!mppts_enabled){
                printf("Sending Set Mode Command to enable all MPPTs\r\n");
            }
            mppts_enabled = true;
            enableAllMPPTs(pdMS_TO_TICKS(PRECHARGE_TASK_DELAY_MS/2));
        }
        else{
            if(mppts_enabled){
                printf("Sending Set Mode Command to disable all MPPTs\r\n");
            }
            mppts_enabled = false;
            disableAllMPPTs(pdMS_TO_TICKS(PRECHARGE_TASK_DELAY_MS/2));
        }
    }
}
