lhr-solar/PS-BPSLeader/Software/Core/Inc/common.h

#pragma once

#include "FreeRTOS.h"
#include "semphr.h"
#include "task.h"
#include "queue.h"
#include "stm32xx_hal.h"
#include <timers.h>
#include <stdio.h>
#include <stdbool.h>
#include "config.h"
#include "drive_profile_config.h"

#include "pindef.h"

#include "faultHandler.h"

typedef enum {
    NORMAL = 0,   // We good
    EMERGENCY = 1  // We bad
} fault_state_t;    

void Fault_Handler(void);
void Error_Handler(void);
void SystemClock_Config(void);

/**
 * @brief Calculates the elapsed time between two RTOS tick measurements.
 * @param newTime The most recent tick count reading (typically from xTaskGetTickCount()).
 * @param oldTime The previous tick count reading to compare against.
 * @return TickType_t The elapsed time in ticks.
 */
TickType_t Calculate_TimeDifference(TickType_t newTime, TickType_t oldTime);
