lhr-solar/PS-BPSLeader/(commit log)

2026-09-14 part numbers
    [100PinMCU.kicad_sch, 12VBuck.kicad_sch, 12V_Buck_Boost.kicad_sch, BMS.kicad_sch, BPS_CAN_Transceiver.kicad_sch, Car_CAN_Transceiver.kicad_sch, Charger_CAN_Transceiver.kicad_sch, ESP32.kicad_sch]
2026-09-14 silkscreen changes
    [PS-BPSLeader.kicad_pcb]
2026-09-15 removed csv from gitignore
    [bom.csv, designators.csv, positions.csv]
2026-09-23 fixed fan chip footprint and buck output capacitors
    [12VBuck.kicad_sch, Fan.kicad_sch, PS-BPSLeader.kicad_pcb, bom.csv, designators.csv, positions.csv]
2026-10-13 Array integration (#25)
    * started array precharge code
    * add tpee datasheet
    * not compiling precharge code
    * add some precharge debug statements
    * MPPT enable code + revert to old mV can messages
    * forgot to actually enable MPPT in driver
    * addressed some reviews
    * change fuckah names of variables
    * change the adc generator script
    * add some extra debug statements in precharge and voltage monitor task
    * add printouts to print module faulted values and current values in a fault
    * bps workie and more compact printouts
    * forgot to reenable vt temp can watchdog
    * fix precharge lut generator script
    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
